adam-ctrlc/bottle-recycler/(commit log)

2026-10-23 Bottle recycler: Arduino machine that gives a coin for each plastic bottle
    TCRT5000 sensor detects the bottle, servo on D3 takes it in, servo on D2
    pushes a coin out, and a 16x2 I2C LCD guides the user. Includes an I2C
    scanner sketch and wiring/power notes in the README.
2026-10-23 Move the sketch to the repo root and drop the I2C scanner
2026-10-24 Fix free/lost/double coins, add retries and power-cut recovery
    - Pay only after the sensor confirms the bottle went in; retry the flap
    up to 3 times, otherwise show "Bottle is stuck" and pay nothing
    - Mark the bottle as pending in EEPROM so a power cut mid-cycle finishes
    it on restart, and clear it at the end of the coin push so a cut on the
    return stroke can't pay twice
    - Save the servo angle closest to rest so restarting never swings a servo
    forward; reset EEPROM left over from other sketches
    - Require the sensor to be clear for 300 ms in a row; use the pin's pull-up
    - Keep running without the LCD (onboard LED on), restart it after servo
    moves, and set an I2C timeout so wire nois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
    [bottle_recycler.ino, config.h, display.cpp, display.h]
2026-10-24 README: add labeled close-ups of the screen and the Arduino
